lzq888/bldcdriver/hardware/3 Phase Inverter.sch

## KiCad design hardware/3 Phase Inverter.sch (2015-06-14, an earlier design)

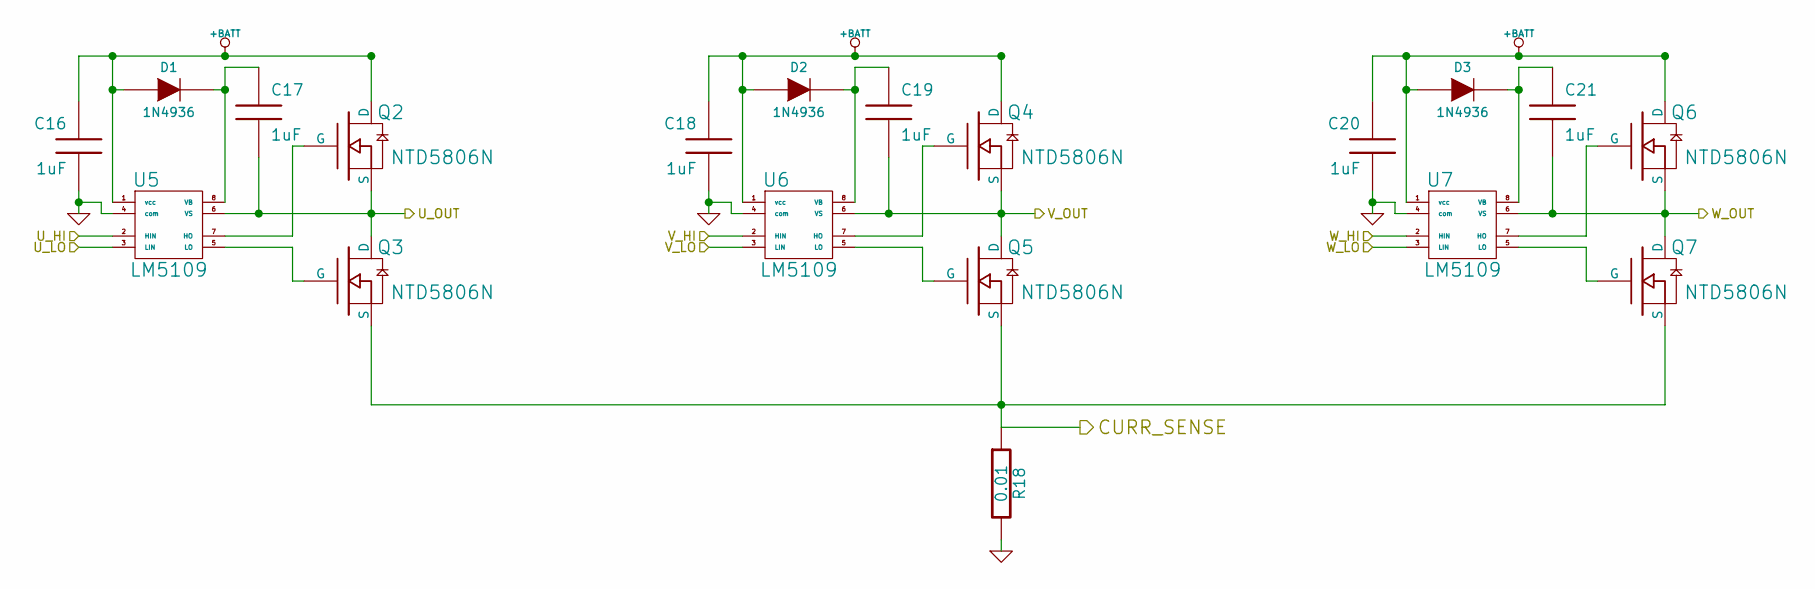
[picture p5: schematic 3 Phase Inverter.sch]

Parts:
C16, C17, C18, C19, C20, C21: 1uF; Mfg P/N FK24X7R1H105K; Digikey P/N 445-8517-ND
D1, D2, D3: 1N4936; DO-41; Mfg P/N 1N4936; Digikey P/N 1N4936FSCT-ND
Q2, Q3, Q4, Q5, Q6, Q7: NTD5806N; DPAK; Mfg P/N NTD5806NT4G; Digikey P/N NTD5806NT4GOSCT-ND
R18: 0.01; Mfg P/N MPR5JB10L0; Digikey P/N MPR5JB10L0-ND
U5, U6, U7: LM5109; SOIC8; Mfg P/N LM5109MA/NOPB; Digikey P/N LM5109MA/NOPB-ND

Connections:
+BATT: C16.1, C18.1, C20.1, D1.1 (A), D2.1 (A), D3.1 (A), Q2.2 (D), Q4.2 (D), Q6.2 (D), U5.1 (vcc), U6.1 (vcc), U7.1 (vcc)
CURR_SENSE: Q3.3 (S), Q5.3 (S), Q7.3 (S), R18.1
GND: C16.2, C18.2, C20.2, R18.2, U5.4 (com), U6.4 (com), U7.4 (com)
unnamed: C17.1, D1.2 (K), U5.8 (VB)
unnamed: C19.1, D2.2 (K), U6.8 (VB)
unnamed: C21.1, D3.2 (K), U7.8 (VB)
unnamed: Q2.1 (G), U5.7 (HO)
unnamed: Q3.1 (G), U5.5 (LO)
unnamed: Q4.1 (G), U6.7 (HO)
unnamed: Q5.1 (G), U6.5 (LO)
unnamed: Q6.1 (G), U7.7 (HO)
unnamed: Q7.1 (G), U7.5 (LO)
U_HI: U5.2 (HIN)
U_LO: U5.3 (LIN)
U_OUT: C17.2, Q2.3 (S), Q3.2 (D), U5.6 (VS)
V_HI: U6.2 (HIN)
V_LO: U6.3 (LIN)
V_OUT: C19.2, Q4.3 (S), Q5.2 (D), U6.6 (VS)
W_HI: U7.2 (HIN)
W_LO: U7.3 (LIN)
W_OUT: C21.2, Q6.3 (S), Q7.2 (D), U7.6 (VS)
