lzq888/bldcdriver/hardware/Microcontroller.sch

## KiCad design hardware/Microcontroller.sch (2015-06-14, an earlier design)

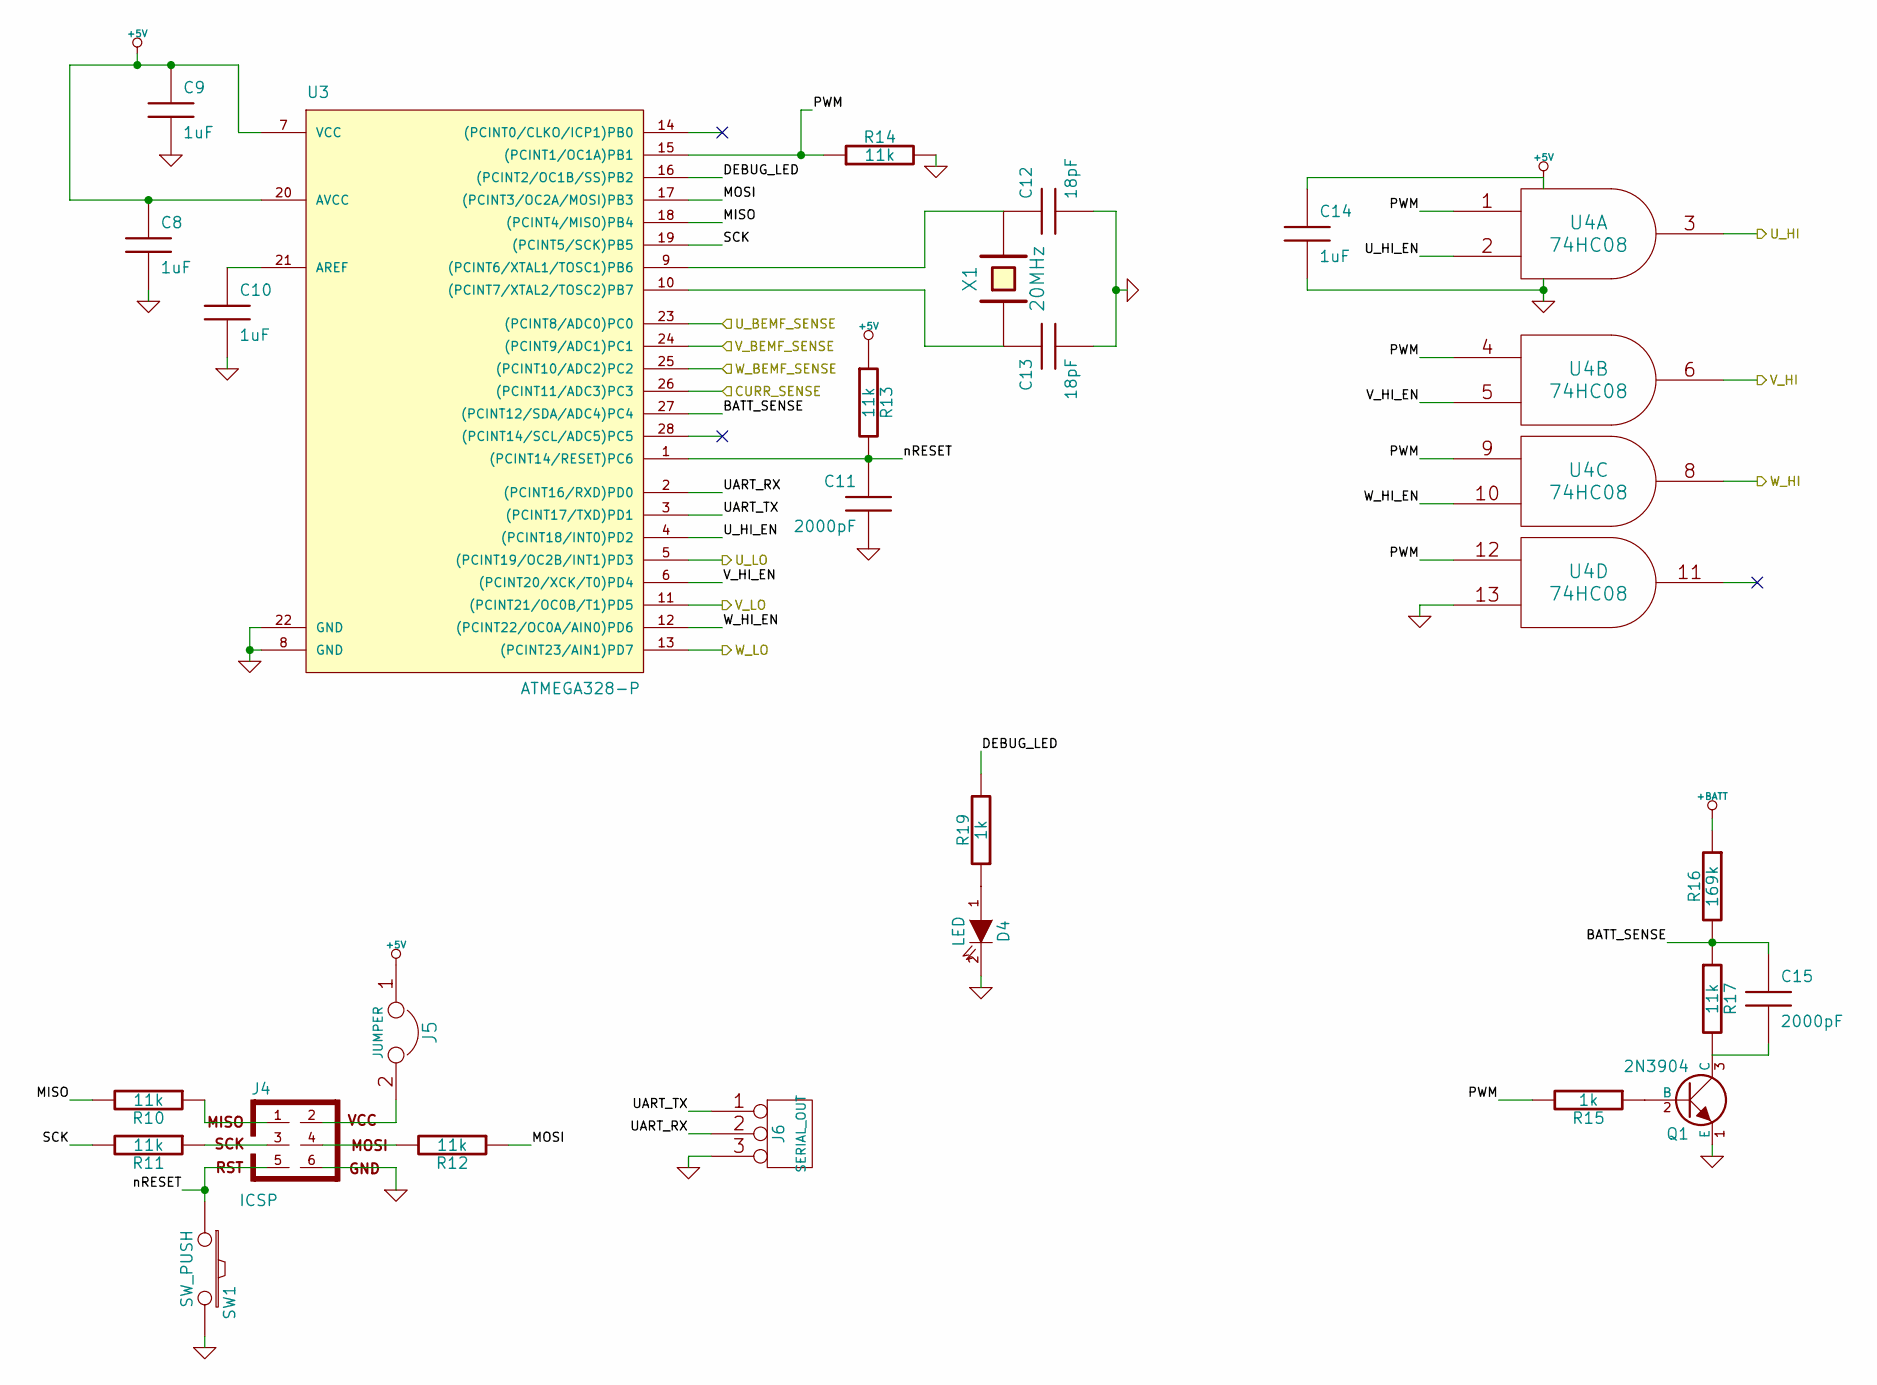
[picture p6: schematic Microcontroller.sch]

Parts:
C8, C9, C10, C14: 1uF; Mfg P/N FK24X7R1H105K; Digikey P/N 445-8517-ND
C11, C15: 2000pF; Mfg P/N S202M29Z5UN63L6R; Digikey P/N 1268PH-ND
C12, C13: 18pF; Mfg P/N FK18C0G1H180J; Digikey P/N 445-4762-ND
D4: LED
J4: ICSP; 3x2 0.1\"; Mfg P/N 30306-6002HB; Digikey P/N 3M15451-ND
J5: JUMPER
J6: SERIAL_OUT; 3x1 0.1\"; Mfg P/N PREC040SAAN-RC; Digikey P/N S1012EC-40-ND
Q1: 2N3904; TO-92-3; Mfg P/N 2N3904BU; Digikey P/N 2N3904FS-ND
R10, R11, R12, R13, R14, R17: 11k; Mfg P/N MFR-25FBF52-11K; Digikey P/N 11.0KXBK-ND
R15, R19: 1k; Mfg P/N MFR-25FBF52-1K; Digikey P/N 1.00KXBK-ND
R16: 169k; Mfg P/N MFR-25FBF52-169K; Digikey P/N 169KXBK-ND
SW1: SW_PUSH
U3: ATMEGA328-P; DIL28
U4: 74HC08; Mfg P/N SN74HC08N; Digikey P/N 296-1570-5-ND
X1: 20MHz; HC49; Mfg P/N 9B-20.000MBBK-B; Digikey P/N 887-2018-ND

Connections:
+5V: C8.1, C9.1, C14.1, J5.1, R13.1, U3.7 (VCC), U3.20 (AVCC), U4.14 (VCC)
+BATT: R16.1
BATT_SENSE: C15.1, R16.2, R17.1, U3.27 ((PCINT12/SDA/ADC4)PC4)
CURR_SENSE: U3.26 ((PCINT11/ADC3)PC3)
DEBUG_LED: R19.2, U3.16 ((PCINT2/OC1B/SS)PB2)
GND: C8.2, C9.2, C10.2, C11.2, C12.2, C13.2, C14.2, D4.2 (K), J4.6, J6.3, Q1.1 (E), R14.2, SW1.2, U3.8 (GND), U3.22 (GND), U4.7 (GND), U4.13
MISO: R10.2, U3.18 ((PCINT4/MISO)PB4)
MOSI: R12.1, U3.17 ((PCINT3/OC2A/MOSI)PB3)
unnamed: C10.1, U3.21 (AREF)
unnamed: C12.1, U3.9 ((PCINT6/XTAL1/TOSC1)PB6), X1.2
unnamed: C13.1, U3.10 ((PCINT7/XTAL2/TOSC2)PB7), X1.1
unnamed: C15.2, Q1.3 (C), R17.2
unnamed: D4.1 (A), R19.1
unnamed: J4.1, R10.1
unnamed: J4.2, J5.2
unnamed: J4.3, R11.1
unnamed: J4.4, R12.2
unnamed: Q1.2 (B), R15.1
PWM: R14.1, R15.2, U3.15 ((PCINT1/OC1A)PB1), U4.1, U4.4, U4.9, U4.12
SCK: R11.2, U3.19 ((PCINT5/SCK)PB5)
UART_RX: J6.2 (PM), U3.2 ((PCINT16/RXD)PD0)
UART_TX: J6.1, U3.3 ((PCINT17/TXD)PD1)
U_BEMF_SENSE: U3.23 ((PCINT8/ADC0)PC0)
U_HI: U4.3
U_HI_EN: U3.4 ((PCINT18/INT0)PD2), U4.2
U_LO: U3.5 ((PCINT19/OC2B/INT1)PD3)
V_BEMF_SENSE: U3.24 ((PCINT9/ADC1)PC1)
V_HI: U4.6
V_HI_EN: U3.6 ((PCINT20/XCK/T0)PD4), U4.5
V_LO: U3.11 ((PCINT21/OC0B/T1)PD5)
W_BEMF_SENSE: U3.25 ((PCINT10/ADC2)PC2)
W_HI: U4.8
W_HI_EN: U3.12 ((PCINT22/OC0A/AIN0)PD6), U4.10
W_LO: U3.13 ((PCINT23/AIN1)PD7)
nRESET: C11.1, J4.5, R13.2, SW1.1, U3.1 ((PCINT14/RESET)PC6)
