lzq888/bldcdriver/hardware/Signal Conditioning.sch

## KiCad design hardware/Signal Conditioning.sch (2015-06-14, an earlier design)

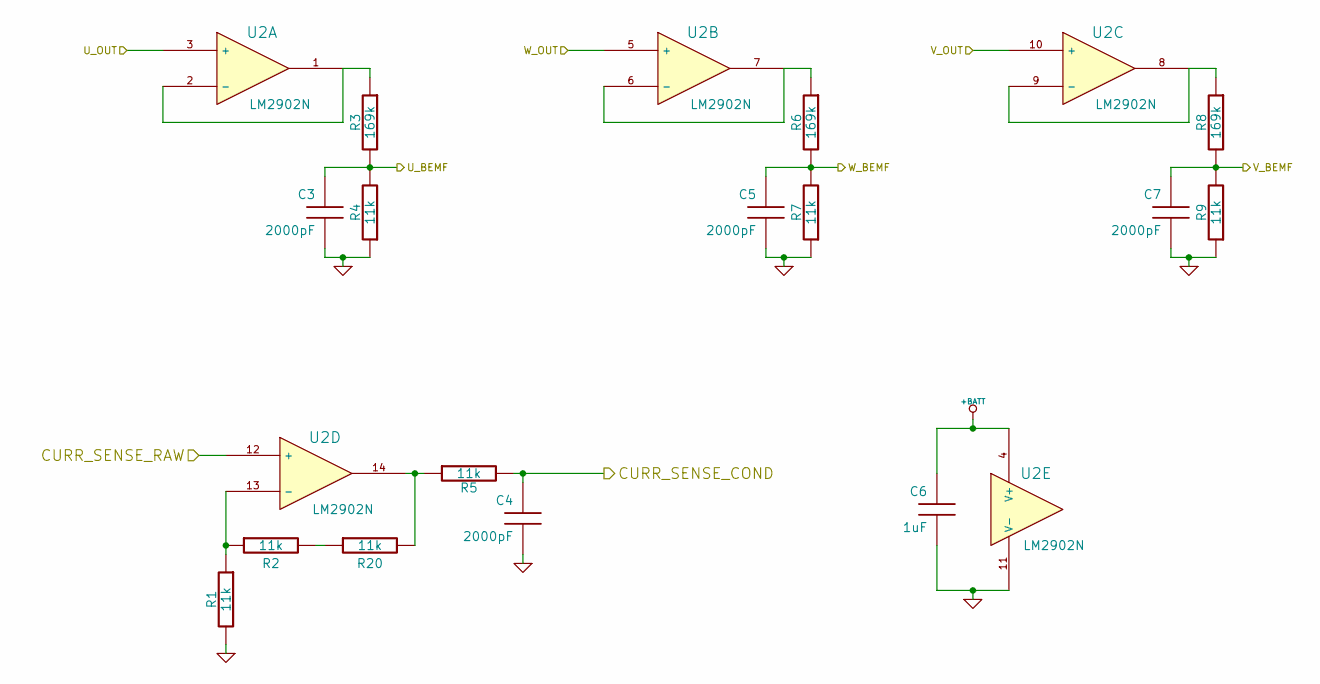
[picture p7: schematic Signal Conditioning.sch]

Parts:
C3, C4, C5, C7: 2000pF; Mfg P/N S202M29Z5UN63L6R; Digikey P/N 1268PH-ND
C6: 1uF; Mfg P/N FK24X7R1H105K; Digikey P/N 445-8517-ND
R1, R5: 11k; Mfg P/N MFR-25FBF52-7K15; Digikey P/N 7.15KXBK-ND
R2, R20: 11k; Mfg P/N MFR-25FBF52-169K; Digikey P/N 169KXBK-ND
R3, R6, R8: 169k; Mfg P/N MFR-25FBF52-169K; Digikey P/N 169KXBK-ND
R4, R7, R9: 11k; Mfg P/N MFR-25FBF52-11K; Digikey P/N 11.0KXBK-ND
U2: LM2902N

Connections:
+BATT: C6.1, U2.4 (V+)
CURR_SENSE_COND: C4.1, R5.2
CURR_SENSE_RAW: U2.12 (+)
GND: C3.2, C4.2, C5.2, C6.2, C7.2, R1.2, R4.1, R7.1, R9.1, U2.11 (V-)
unnamed: R1.1, R2.1, U2.13 (-)
unnamed: R2.2, R20.1
unnamed: R3.1, U2.1, U2.2 (-)
unnamed: R6.1, U2.6 (-), U2.7
unnamed: R8.1, U2.8, U2.9 (-)
unnamed: R5.1, R20.2, U2.14
U_BEMF: C3.1, R3.2, R4.2
U_OUT: U2.3 (+)
V_BEMF: C7.1, R8.2, R9.2
V_OUT: U2.10 (+)
W_BEMF: C5.1, R6.2, R7.2
W_OUT: U2.5 (+)
