lzq888/bldcdriver/hardware/bldc.sch

## KiCad design hardware/bldc.sch (2015-06-14, an earlier design)

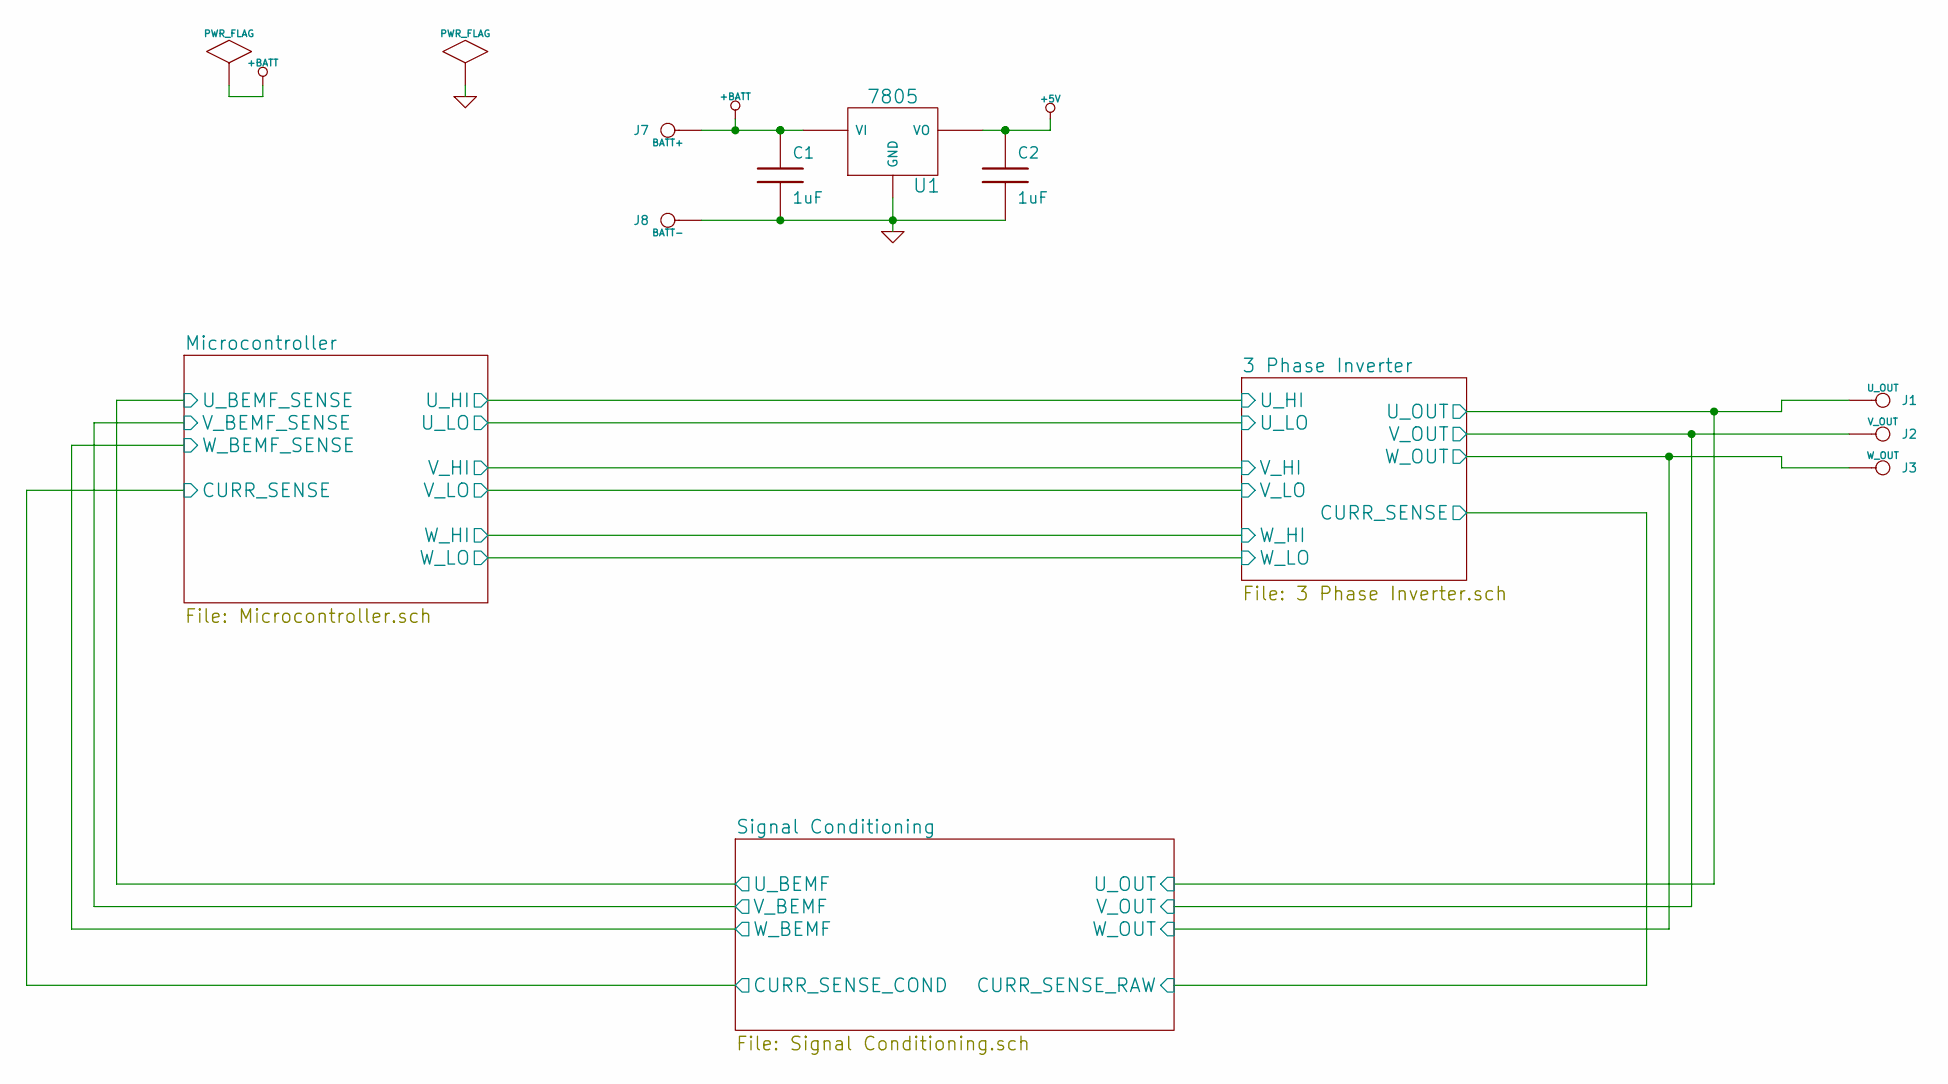
[picture p8: schematic bldc.sch]

Parts:
C1, C2: 1uF; Mfg P/N FK24X7R1H105K; Digikey P/N 445-8517-ND
J1: U_OUT
J2: V_OUT
J3: W_OUT
J7: BATT+
J8: BATT-
U1: 7805

Connections:
+5V: C2.1, U1.VO
+BATT: C1.1, J7.1, U1.VI
GND: C1.2, C2.2, J8.1, U1.GND
U_OUT: J1.1
V_OUT: J2.1
W_OUT: J3.1
