lzq888/bldcdriver/software/bldcdriver/main.c

/**
 * main.c - The program entry point
 *
 * Copyright (c) 2015 Joseph Angelo
 *
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
 * THE SOFTWARE IS PROVIDED "AS IS", WITHOUT WARRANTY OF ANY KIND, EXPRESS OR
 * IMPLIED, INCLUDING BUT NOT LIMITED TO THE WARRANTIES OF MERCHANTABILITY,
 * FITNESS FOR A PARTICULAR PURPOSE AND NONINFRINGEMENT. IN NO EVENT SHALL THE
 * AUTHORS OR COPYRIGHT HOLDERS BE LIABLE FOR ANY CLAIM, DAMAGES OR OTHER
 * LIABILITY, WHETHER IN AN ACTION OF CONTRACT, TORT OR OTHERWISE, ARISING FROM,
 * OUT OF OR IN CONNECTION WITH THE SOFTWARE OR THE USE OR OTHER DEALINGS IN THE
 * SOFTWARE.
 */
#include <stdint.h>
#include <avr/io.h>
#include <avr/wdt.h>
#include "bldcdriver.h"
#include "uart.h"
#include "pwm.h"
#include "led.h"

int main(void)
{
	wdt_enable(WDTO_120MS);
	wdt_reset();

	led_init();
	led_turnOn();

	uart_init();
	uart_putChar('>');

	pwm_init();
	pwm_setDutyCycle(PWM_MAX >> 2);
	pwm_start();

	while (1)
	{
		wdt_reset();
	}

	return 0;
}
