lzq888/bldcdriver/(commit log)

2015-04-20 Added the inital hardware CAD files
    [3 Phase Inverter.sch, Microcontroller.sch, Signal Conditioning.sch, bldc.sch]
2015-04-20 Added a pdf of the schematic
    [3 Phase Inverter.sch, Microcontroller.sch, Signal Conditioning.sch, bldc.sch]
2015-04-25 Modified the components in the 3 phase inverter
    [3 Phase Inverter.sch, Microcontroller.sch, Signal Conditioning.sch, bldc.sch]
2015-04-26 Updated the Part number and footprints for most components
    [3 Phase Inverter.sch, Microcontroller.sch, Signal Conditioning.sch, bldc.sch]
2015-04-26 Fixed the unit assignments for the opamps
    [3 Phase Inverter.sch, Microcontroller.sch, Signal Conditioning.sch, bldc.sch]
2015-05-02 Modified schematic to use one less op-amp and a cheaper microcontroller
    [3 Phase Inverter.sch, Microcontroller.sch, Signal Conditioning.sch, bldc.sch]
2015-05-02 Generated a netlist with footprints
2015-05-21 Modified schemdatic to use a single PWM channel, similar to Atmel's app note.
    [3 Phase Inverter.sch, Microcontroller.sch, Signal Conditioning.sch, bldc.sch]
2015-05-21 Changed most parts to be through hole to simplify the initial prototype assembly
    [3 Phase Inverter.sch, Microcontroller.sch, Signal Conditioning.sch, bldc.sch]
2015-05-21 Changed the current sense conditioning to work with shunt resistor value change
    [3 Phase Inverter.sch, Microcontroller.sch, Signal Conditioning.sch, bldc.sch]
2015-06-14 Added inital layout revision.
    [3 Phase Inverter.sch, Microcontroller.sch, Signal Conditioning.sch, bldc.brd, bldc.sch]
2015-06-14 Generated gerber files
    [bldc.brd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]
2015-06-14 Increased the size of the current sense vias.
    [bldc.brd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]
2015-06-14 Fixed item properties and generated a BOM.
    [3 Phase Inverter.sch, Microcontroller.sch, Signal Conditioning.sch, bldc-bom.csv, bldc.sch]
2015-07-06 Added initial changes for ISR driven UART
2015-07-09 Added a simple PWM interface
2015-07-10 Added functions for controlling the debug LED
2015-07-10 Made small changes to the PWM functions
2015-07-11 Added basic functions for controlling the ADC
2015-07-11 Changed the ADC driver to be interrupt based
2015-07-11 Added interrupt data protection to the UART module
2015-07-11 Switched to using the ATOMIC_BLOCK macro in avr-libc
2015-07-11 Changed the eeprom data names to avoid future conflicts.
    [eepromData.c, eepromData.h]
